radu-chc/Wirelessly-Controlled-Robot-Through-Advanced-Arm-Motion-Capture-Tracking-and-Gesture-Recognition/Report/APC220Kit-3-600x600.jpg

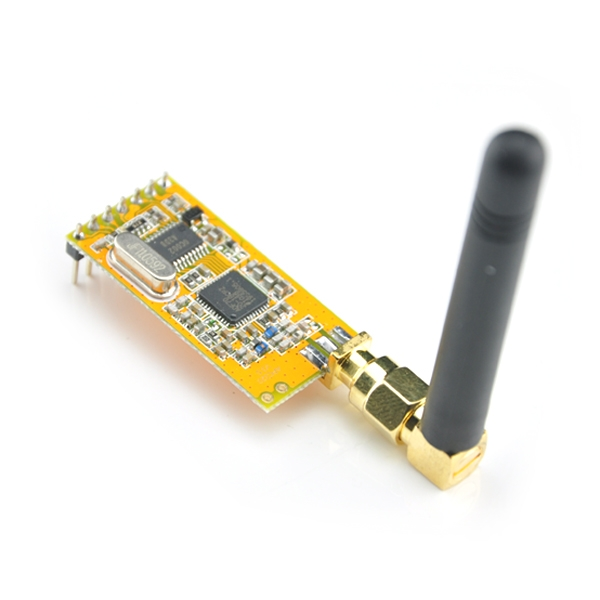
Report/APC220Kit-3-600x600.jpg
