radu-chc/Wirelessly-Controlled-Robot-Through-Advanced-Arm-Motion-Capture-Tracking-and-Gesture-Recognition/Report/arrow.jpg

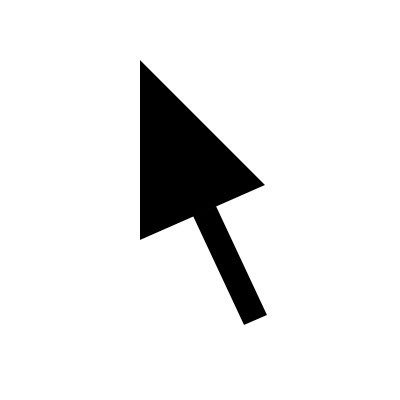
Report/arrow.jpg
