radu-chc/Wirelessly-Controlled-Robot-Through-Advanced-Arm-Motion-Capture-Tracking-and-Gesture-Recognition/Report/backside_robot.JPG

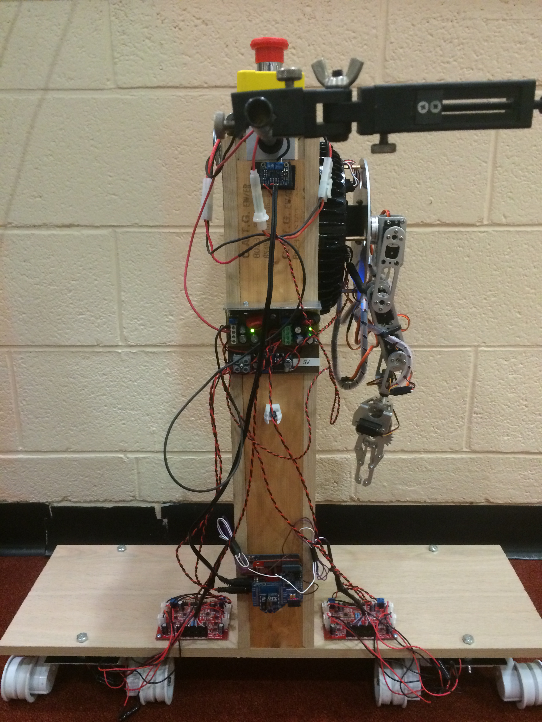
Report/backside_robot.JPG
