radu-chc/Wirelessly-Controlled-Robot-Through-Advanced-Arm-Motion-Capture-Tracking-and-Gesture-Recognition/Report/robotic_arm_with_tool.jpg

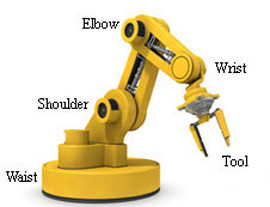
Report/robotic_arm_with_tool.jpg
