radu-chc/Wirelessly-Controlled-Robot-Through-Advanced-Arm-Motion-Capture-Tracking-and-Gesture-Recognition/RobotArmController - KinectV2/Images/ArmActive.png

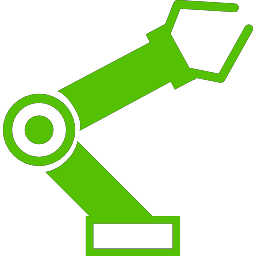
RobotArmController - KinectV2/Images/ArmActive.png
