radu-chc/Wirelessly-Controlled-Robot-Through-Advanced-Arm-Motion-Capture-Tracking-and-Gesture-Recognition/RobotArmController - KinectV2/Images/LeapActive2.png

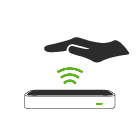
RobotArmController - KinectV2/Images/LeapActive2.png
